rocketscream/UPDI-USB-SERIAL/README.md

# UPDI-USB-SERIAL
A dual USB port adapter with built-in UPDI programmer and a dedicated USB-serial interface board.

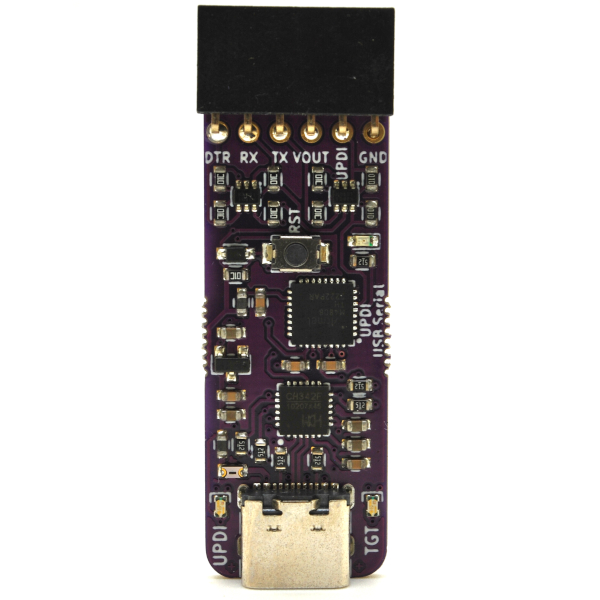
[picture p1: UPDI-USB-SERIAL.jpg]
