rocketscream/UPDI-USB-SERIAL/UPDI-USB-SERIAL.pdf

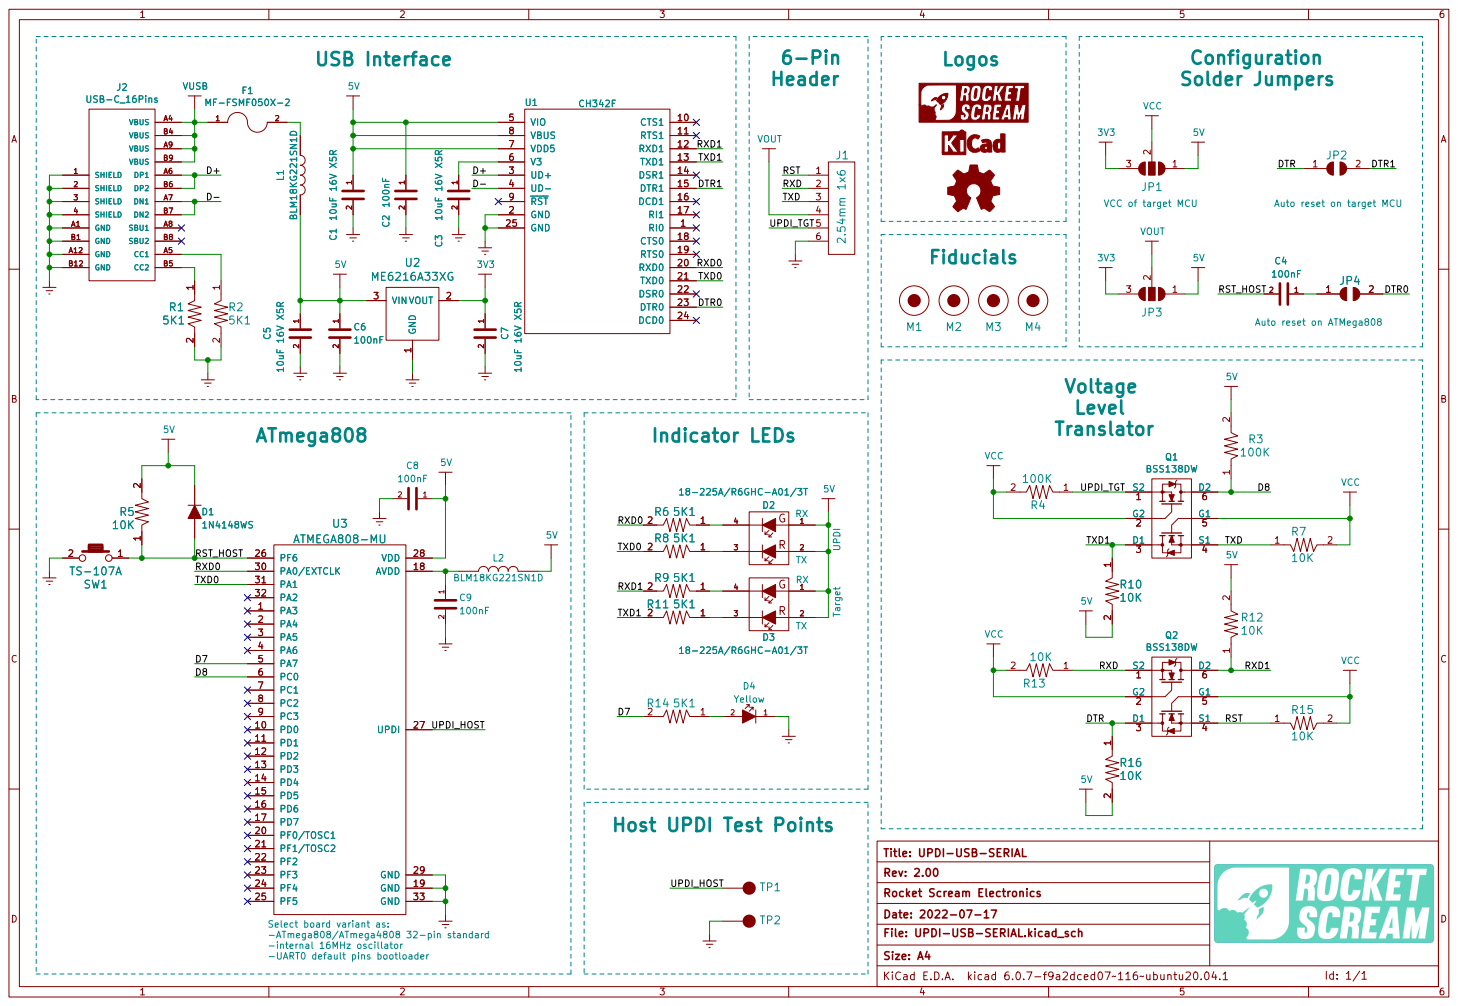
[picture p2: page 1]

VCC of target MCU

Auto reset on target MCU

Host UPDI Test Points

Id: 1/1 Title: UPDI-USB-SERIAL
D Date: 2022-07-17 KiCad E.D.A. kicad 6.0.7-f9a2dced07~116~ubuntu20.04.1 Rev: 2.00 Size: A4
File: UPDI-USB-SERIAL.kicad_sch Rocket Scream Electronics

Select board variant as: -ATmega808/ATmega4808 32-pin standard
