rocketscream/UPDI-USB-SERIAL/UPDI-USB-SERIAL.kicad_pcb

## KiCad design UPDI-USB-SERIAL.kicad_pcb (2022-09-25)

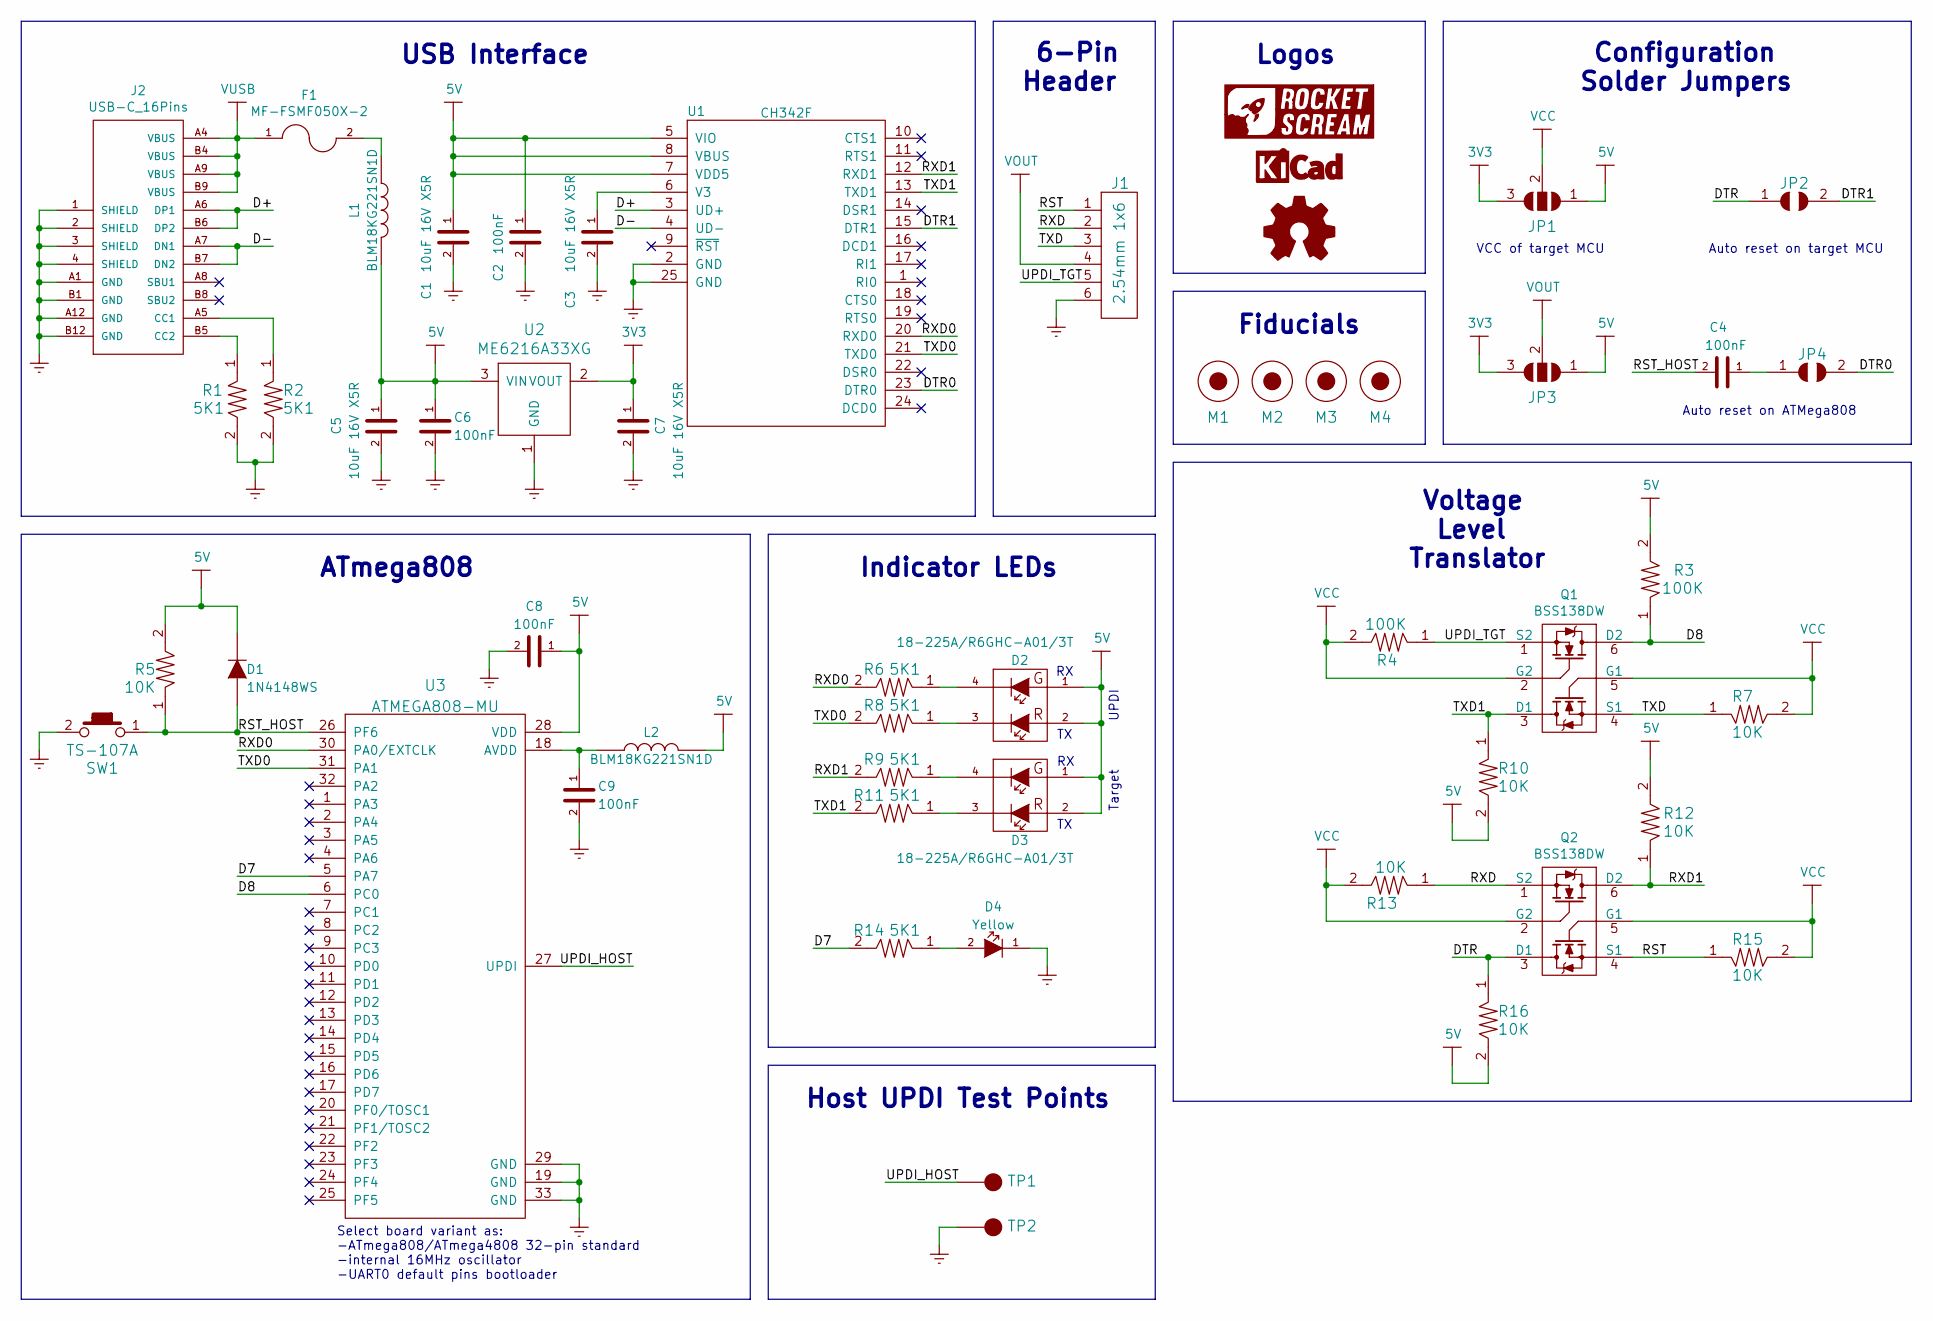
[picture p3: schematic UPDI-USB-SERIAL.kicad_sch]

Parts:
C1, C3, C5, C7: 10uF 16V X5R; C_0603
C2, C4, C6, C8, C9: 100nF; C_0603
D1: 1N4148WS; SOD-323
D2, D3: 18-225A/R6GHC-A01/3T; LED-18-225
D4: Yellow; LED_0603
F1: MF-FSMF050X-2; MF-FSMF
J1: 2.54mm 1x6; RCP_1x6_Pitch2.54mm_RightAngle
J2: USB-C_16Pins; TYPE-C16PIN
JP1, JP3: JUMPER-2-WAY; JUMPER-2-WAY-SMD
JP2, JP4: JUMPER-1-WAY; JUMPER-1-WAY-SMD
L1, L2: BLM18KG221SN1D; I_0603
LOGO1: LOGO-ROCKET-SCREAM-HORIZONTAL; LOGO-ROCKET-SCREAM_Horizontal_XSmall
LOGO2: LOGO-OSHW; LOGO-OSHW_XSmall
LOGO3: LOGO-KICAD; LOGO-KICAD_XXXSmall
M1, M2, M3, M4: FIDUCIAL; FIDUCIAL-0.5MM_CROSS
Q1, Q2: BSS138DW; SOT-363_Diodes_Inc
R1, R2, R6, R8, R9, R11, R14: 5K1; R_0603
R3, R4: 100K; R_0603
R5, R7, R10, R12, R13, R15, R16: 10K; R_0603
SW1: TS-107A
TP1, TP2: TEST-PAD; TEST-PAD-1.5MM
U1: CH342F; QFN-24_4x4mm_Pitch0.5mm
U2: ME6216A33XG; SOT-23
U3: ATMEGA808-MU; QFN-32_5x5mm_Pitch0.5mm

Connections:
3V3: C7.1, JP1.3, JP3.3, U2.2 (VOUT)
5V: C1.1, C2.1, C5.1, C6.1, C8.1, D1.1 (K), D2.1 (A), D2.2 (A), D3.1 (A), D3.2 (A), JP1.1, JP3.1, L1.2, L2.2, R3.2, R5.2, R10.2, R12.2, R16.2, U1.5 (VIO), U1.7 (VDD5), U1.8 (VBUS), U2.3 (VIN), U3.28 (VDD)
/D7: R14.2, U3.5 (PA7)
/D8: Q1.6 (D2), R3.1, U3.6 (PC0)
/D+: J2.A6 (DP1), J2.B6 (DP2), U1.3 (UD+)
/D-: J2.A7 (DN1), J2.B7 (DN2), U1.4 (UD-)
/DTR: JP2.1, Q2.3 (D1), R16.1
/DTR0: JP4.2, U1.23 (DTR0)
/DTR1: JP2.2, U1.15 (DTR1)
/RST: J1.1, Q2.4 (S1), R15.1
/RST_HOST: C4.2, D1.2 (A), R5.1, SW1.1, U3.26 (PF6)
/RXD: J1.2, Q2.1 (S2), R13.1
/RXD0: R6.2, U1.20 (RXD0), U3.30 (PA0/EXTCLK)
/RXD1: Q2.6 (D2), R9.2, R12.1, U1.12 (RXD1)
/TXD: J1.3, Q1.4 (S1), R7.1
/TXD0: R8.2, U1.21 (TXD0), U3.31 (PA1)
/TXD1: Q1.3 (D1), R10.1, R11.2, U1.13 (TXD1)
/UPDI_HOST: TP1.1, U3.27 (UPDI)
/UPDI_TGT: J1.5, Q1.1 (S2), R4.1
GND: C1.2, C2.2, C3.2, C5.2, C6.2, C7.2, C8.2, C9.2, D4.1 (K), J1.6, J2.1 (SHIELD), J2.2 (SHIELD), J2.3 (SHIELD), J2.4 (SHIELD), J2.A1 (GND), J2.A12 (GND), J2.B1 (GND), J2.B12 (GND), R1.2, R2.2, SW1.2, TP2.1, U1.2 (GND), U1.25 (GND), U2.1 (GND), U3.19 (GND), U3.29 (GND), U3.33 (GND)
unnamed: C3.1, U1.6 (V3)
unnamed: C4.1, JP4.1
unnamed: C9.1, L2.1, U3.18 (AVDD)
unnamed: D2.3 (K), R8.1
unnamed: D2.4 (K), R6.1
unnamed: D3.3 (K), R11.1
unnamed: D3.4 (K), R9.1
unnamed: D4.2 (A), R14.1
unnamed: F1.2, L1.1
unnamed: J2.A5 (CC1), R2.1
unnamed: J2.B5 (CC2), R1.1
VCC: JP1.2, Q1.2 (G2), Q1.5 (G1), Q2.2 (G2), Q2.5 (G1), R4.2, R7.2, R13.2, R15.2
VOUT: J1.4, JP3.2
VUSB: F1.1, J2.A4 (VBUS), J2.A9 (VBUS), J2.B4 (VBUS), J2.B9 (VBUS)

Notes on the sheet:
6-Pin Header
UPDI
ATmega808
Auto reset on ATMega808
Target
USB Interface
VCC of target MCU
Host UPDI Test Points
Logos
Configuration Solder Jumpers
Indicator LEDs
Auto reset on target MCU
Select board variant as: -ATmega808/ATmega4808 32-pin standard -internal 16MHz oscillator -UART0 default pins bootloader
Voltage Level Translator
Fiducials

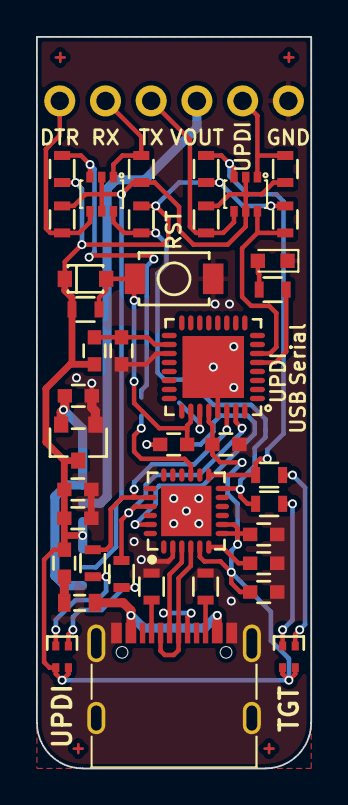
[picture p4: board UPDI-USB-SERIAL.kicad_pcb from above]

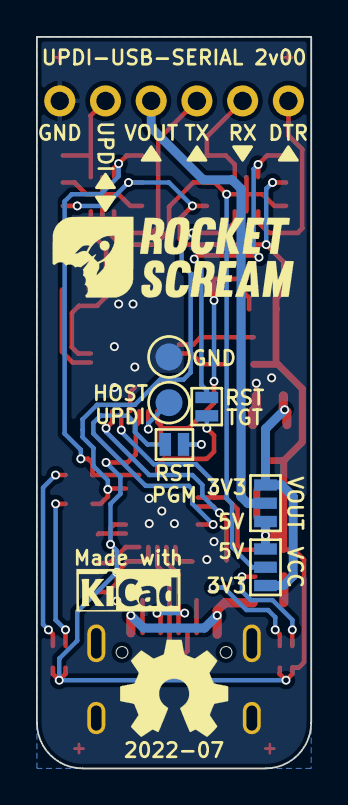
[picture p5: board UPDI-USB-SERIAL.kicad_pcb from below]

Board: 2 copper layers, 15.2 x 40.6 mm, 53 parts (9 on the bottom side), 34 nets.
